benlorenzetti/2015-03-04-Emitter-Coupled-Oscillator/matlab/vary-ce.PNG

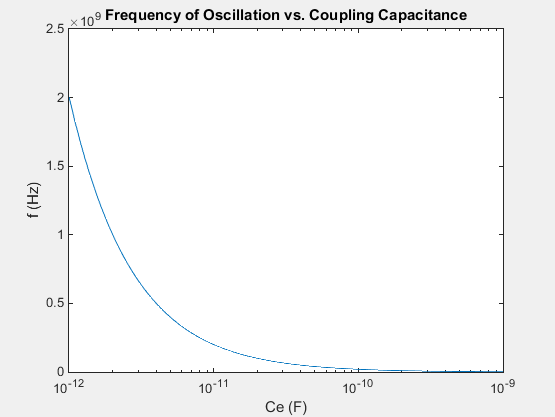
matlab/vary-ce.PNG
