benlorenzetti/2015-03-04-Emitter-Coupled-Oscillator/matlab/vary-icsat.png

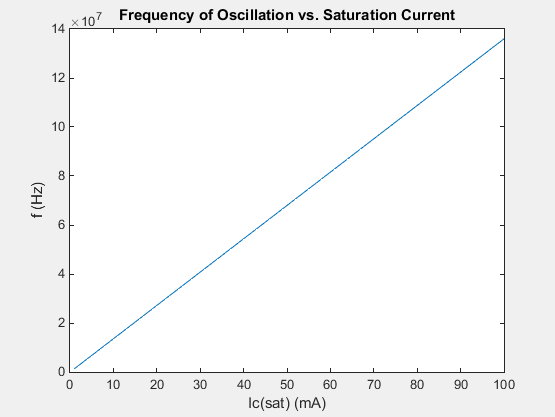
matlab/vary-icsat.png
