benlorenzetti/2015-03-04-Emitter-Coupled-Oscillator/ngspice/advanced-square.png

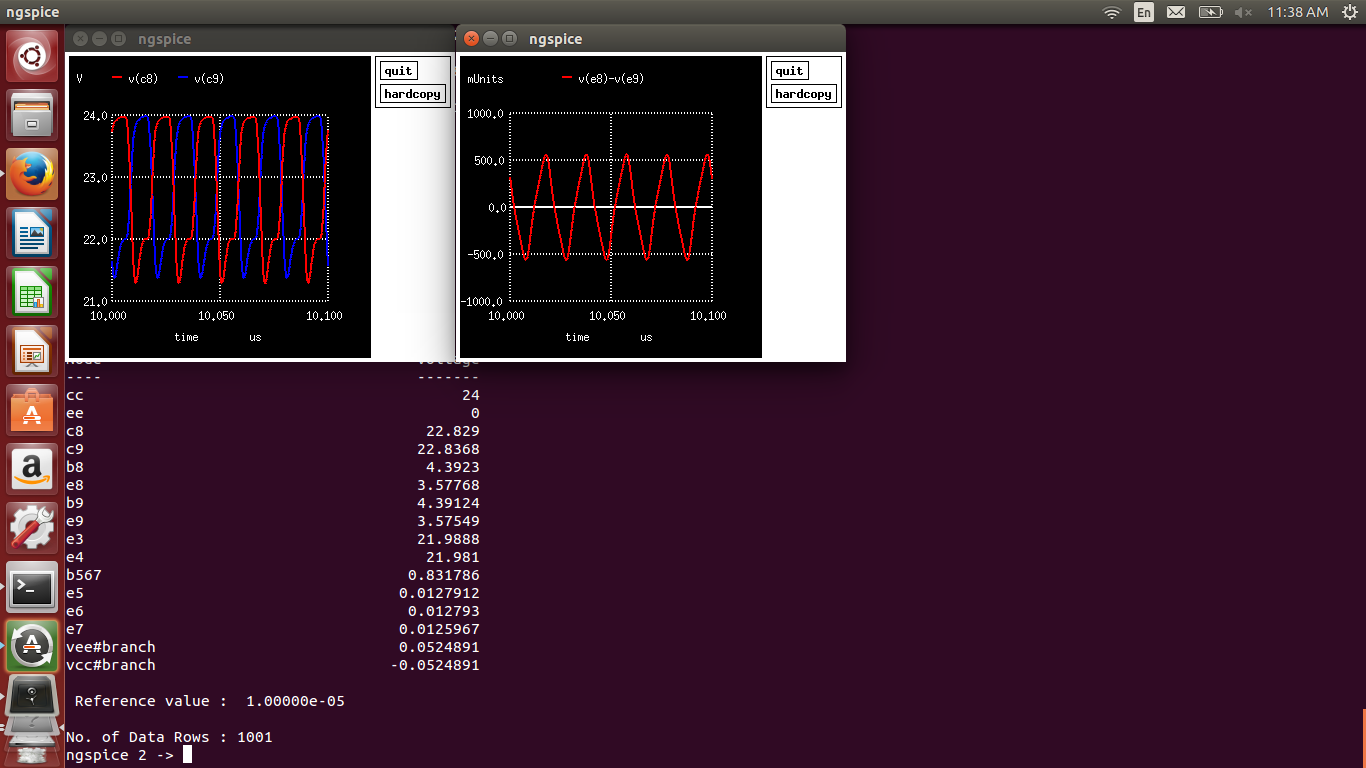
ngspice/advanced-square.png
