benlorenzetti/2015-03-04-Emitter-Coupled-Oscillator/ngspice/simple-square.png

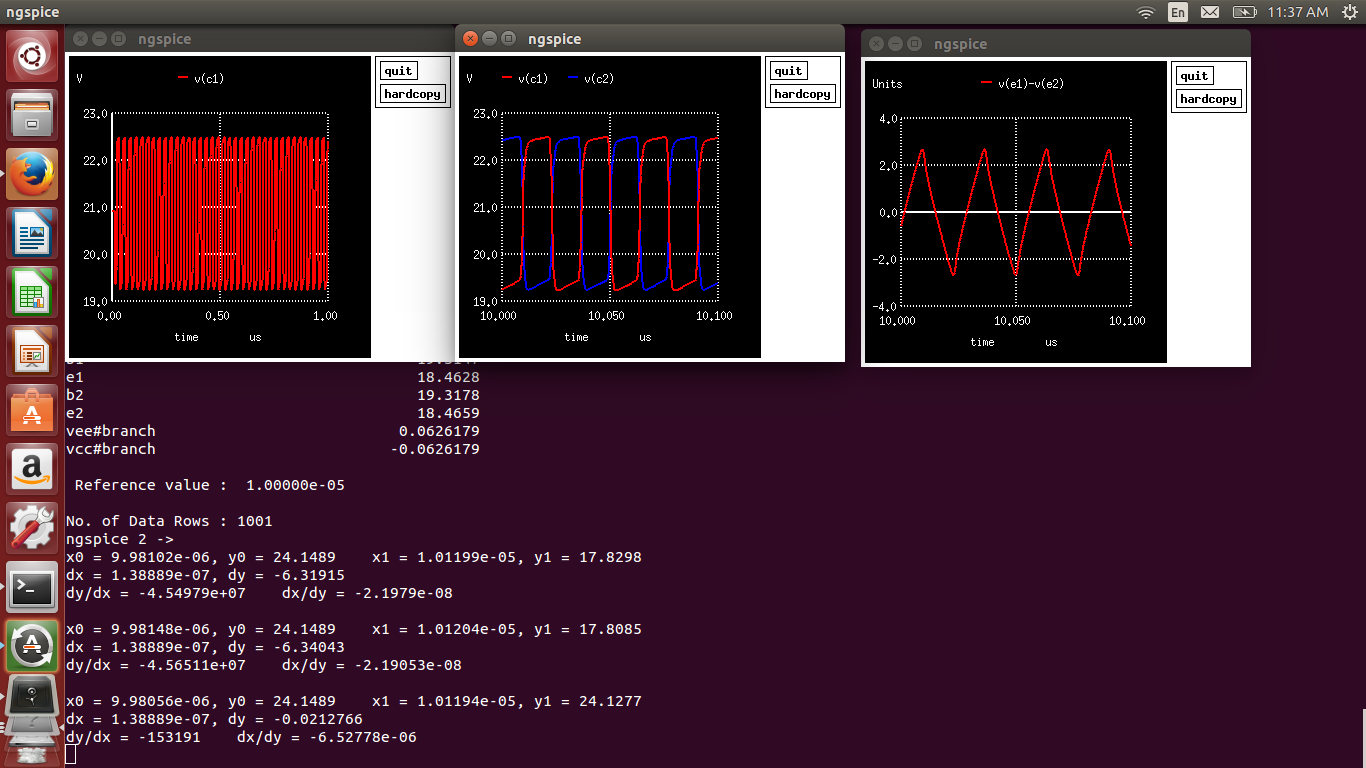
ngspice/simple-square.png
