benlorenzetti/2015-03-04-Emitter-Coupled-Oscillator/results/bjt-characteristics.pdf

TEKTRONIX 571 Curve Tracer

Move cursors IIIIW Pma.x = .1 Hatt Ib.lstep = W uA tl· of stelE = 10 I
F.~loa.d = .25 Ohm
20 l .... : .... : .... : .... : .... : .... : .... : .... : .... : .... :
J | : | :

I

I | : | : | _:-· ~ | , | : | ·. | : | . | .~ . | _.. ... -- ' | . | . | . | . | . | . | . 2 | . ,....- . | . | . | . | . | . | . | . | . mA/di•) 1 .... ;.>··· ... ·~~~~· ........ : .... : ... ·~~--:

Ib= 7£1 uA
I •J ',1 L 1
l
1'~' '=' ,., . .(; l.L.•·-' mn
ill: ~--------- | . | . | .
- • • / . • t" • •••••• .:......:.....: ~ | ..,.....,....,..., •••• ··.-.-• .:...... ••-. -•• -.-. -. ~ ,.~·. | ~ | .- | . lll > ..---· : | : | : | ' | . | . | . | .
If t.... | . | . | ·- I | .•.. | . . | . | .
. · tr>-~·--:· · · · : · · · · : · · · · : · · · · : · · · · : · · · · : · · · · : · · · · : ~ | li/· | . | . | . | . | '--
ilf-.-.~ •....• _ .•....•....•....•....•....•
~b~ 73 uA | J• [)---+ ••••••••••••••••••••• '· ••••••••••• _; I ! | . | . | .
j . (---: -.. -· ...... : |

1
.-1 .- ,., c:.b mH
. ' ..... . ·.---..----...---.-----.----..--· ._. . .
(.: | ,.-
/

0
hFE= 176

Screen copy (since power up) #6

y, -y. -;. W\ ( 1(.._ - )(, )
JZ,3.,.A :. 6.1 ~(2 V +VA)

### VA :.1'2.1 v

Telc

500 mV/di• .. ; | 5000
- v,

Af ~ v

}

TEKTRONIX 571 Curve Tracer 02

Move cursors IIIW Pmax = .1 Ha.tt
o·J.,-d· - .-,c (lh,· I\ dd. - • C..} 'JO '"
Tl; /.::t "t1 = ·11/j IJH" .d.·'·-· ·Cr... | ....L | t
.i.-. ni· dpp~ = 11;1 11 | -I ·..: ···- .. "-~ | tl

•")

c.

20 1 .... : .... : .. '. : | ' |
I : : : . . . .
J . ' ' . : .. ' . : ... ' : .... : .... : .... : .... : | ' ... .
l I | ' . ' .. ' . ' ...... ' ' ' ' ' . ' ....... ' ........ '
rnA. . .id i ,.,. 1 | . _____ ._.:_-___;~-_...J ____ . ·---··-:
I | ·' | .

Ib= 80 uA

## I .-, II

.::: v
_,.:, .. 'J '~'~'·A lL.. •• i... Ill
1 | ' | I | /:-•_,.: .... ----~· It .... ·< | .. | ~ | ·._ | '___.J
l··.tt~~>;-~: | -~····:····:····:···-~:-···:··········
~ . ~i. /~-. . . . : . ' . . : . ' ' . : . . ' . : ' . . . : . . . . : . ' - . : - . | . . ' . - .
., 1,,/ : | ' | . | . | ' | . | . | . | :-··--.
~ ,/"-: Ib= 80 uA | i . '(:...: | ·._ | ;
1./': | ''.' | ' | ... ____, 5 \l

1 ':'1 C: r·A J.i...•·.! ,II

t- FE- 1 r::'J fl - 1-../..J

1. ·-~- | ~--; | ~ .. I .. t .. : | : I | f _,.-.:....._·.· •. ---'---.....__....._~ i ·[_> .. '.:' .. ':. ''.: ' ... : .... :_· :~.·:.' '.:'' .. : .. '.:

1 _.(_ .. :' ... :'.'.:' ' .. : ... ': ... -~~-~~-~-~~

1

,_71, | I / | . | . | . | . | . | . | . | . | . TeJ<: ' i | .
| 0 | | | | | | 500 m'v'/ d i '-.! | | | | 5000

Screen copy (since power up) #1
J2.SM/+ -12.2...,/J,.

## s-v -'Ev

## y-.-;.) -: Wl()(.,_ -K, )

!2.2MA -=- 0./.~ (z V .- V,. )

# vir -:. 12a ·v

TEKTRONIX 571 Curve Tracer

Move cursors IIIW Froax = .1 Ha.tt Ib/step = 5 uA | hlr ·nt·· .::·+ t'- n·~· = 1P l1o L | ·-· ·.- f""-" | 0
Rloa.d = • 25 Ohm
20 l" ... : .... : .... : .... : .... : .... : .... : .... : .... : .... :
i- ... : .... :- ... : .... : .... : . . : . . . : . . . : .... :
I | . | . | . | . | .
2 | j | mA/ d i'J

1

1 | ._. _ ______. --· _......____..,....,.--· | ~-r
I | . ---- | . | . | . | . 1 . . . . y'· . . : . . . . : . . . . : . . . . : . . . . : . . . . : | : ·_;
I | /· ~--· | .----. | . | . | . | . I | .. -~ | . | . | . | .
Ib= 40 uA | 1 · · ~:<::~~ · · : · · · · : · · · · ~ · · · · ~ · · | . · · · · '
I '") '.i | l | (! .. . | . | . | . | . | . | . | . | . | . c. y | i p / . | . ,___,____., | ' | ·.-- | | | .
11.8 mA | ~-~;~::;./~- · ·_: · · · ·: · · · :_i_· · · ·: · · · _ :-· | : · · · ; ·--~-~
j | If'.--- | . | . | . | . | . | . | . | . 1 ·rl · · · · · · · · · · · · · · · · · · · · · · · · · · · · · · · · · · · · · · · · · · · · · · · Ib= 40 uA | 1 | i ....--:- | · | : | : · --: | : | :· | . | . ~
5 \l | J ~/_..- : | : | : | : | : | : | : | : | : | : 12. 1 mA | li--·..:--~-~ . . . . : . . . .;_,~ : . . . . : . . . . : . . . . --: . · | : ,_._.~·-·.-:
i . -/~-~- .... : .... : ... ·0·~:--~~- .. : .... : . . : .... : ~~ I | . | ._. __ ._.._.~.-.. j
' | {-~·: . . . . : . . . . : . . . . : . . . . : . . . . : .. · ~~-_:__~~~~~-~-~._:_,-_:
0 / | Telc

0

Screen copy (since power up) #2
1'2./wtA - Jt:,t>~A
r-v -'2.."

500 mVldiv

### y\. -y, -: M( )(-a. -X, )

1/.t/ M If -:r 0, I ";;A ( 2 V 1+ ~ ) VA -=- 116 v

### s0aJ

TEKTRONIX 571 Curve Tracer

Move cursors llj- Pmax = .1 l~-latt Ib/step = 10 uA Rload = • 2'5 Ohm
20 l' ... : .... : .... : .... : .... : .... : .... : .... : .... : .... : j····:····:···: .... · . : .... : .... : __ ·-: ~

# ff~,/dit.) ]'.'. .~-''

__ ,.: . ...:-----~~' ___ ..,...., | ':
'' .: ':' '=--·.:'. . '':''' . | ':' . | . ''':' -~ . I . | ? | . | . | . | . | , | , | , | , | , I f7> | - | ... Ib= 70 uA

12 v
12 rnA
11: .. jiJj-,-<"_:,_~·-~ ~ | ~-'' ': ''' ': .. '.' '.' .. I! _.- | . | . | .
~ . ~/~-~~ .. : .... : .... > ... : .... :· .... : . :--:
I | I/ ' | . | ' | . | ' | . | . | . | ' | .
I { _:.. | : | : ·-. | . | . | . | . . | . | : 1 . ! _:.-""''; ...... ' | ' | ' ... .
Ib = 70 uA | I ( . | : | . | : | : | : | : | ; | · | · I i -~- | -··. | . | ·. | . | . | . | . | . 5 v

1
.-! 'J r·iH···, c. •. J d

hFE= 171

i ' /'· . : ... ' : .... : . : .. : ' ' ' . : . ' . ' : ' ' ' ' : . : . ·.: .. ' . : ' ' . ' :

I (-- . | . | . | . | . | . | . | .
~ . r .. : .... : .... : .... : .... : .... : .... : .... : .... : .... :
I . -· | . | ~-·~____, I '/ : | .
J ... : | ' .. I | • | . | ._._._.--..-..-.-.:--:--:-.:......:.....:.:.....;_;_..;_;, I ..--· . | . | . I ;/ | : | Telc
0 | 500 mV/div | 5000

Screen copy (since power up) #7
f'J.,3t'YIA -12.a """'A

### s-V- 2.V

## y,. -y, -: m( )(, -K,)

## !2 ""fr " 0.1 ~ (zv .. v,.)

v~ -::.. ;;,; v

d
= <:J. I V

TEKTRONIX 571 Curve Tracer

Move cursors II- Pmax = .1 l·la.tt Ib/step = 10 uA | t,l.-, ,-..j: dpr,-:; = ·1q I 'ff. ._, 1 | •-• '.''- t-'v | J..t_,
' P.'ll-ld-d. = ~·c:: nt-, ~n , , | -- | I S....'.o' | ._.flli 201"": .... : .... : .... : .... : ... ·: ... : | I | . | . | . | . 1 |
I | : | : | : | : | : | : __ :_~ | . | .
m~div j .... /r~---•······;········· ;······· I | / -~· | . | . | . | . | . | .

Ib= 7£1 uA
1

.-, 'I
c. v
12 mA

Ib= 70 uA
5 v
~ .. -, Ji
C:..J filM

hFE= 171

1• {{----~ . . . - •....•••.••• '' • . . , .... i
J.I(C.• ·' /r .

.... · .... ··- ...•....•....•.....•....•. ~
. <--~-~ | : | ( | : | ...J-·.--~--
~ ,·::,·.: ,·r··········~··················~····.····· " | .... : .... : ·.· .. : .... : .... : | ·~~~~~
I If | · | · | · | · | · | · | · | · | · 0 1 )>~:. : .... : .... : .... : .... · ... ·. · . ~-· -~~~~.;....:.· ·....:_· :.....:..· · ..:...:· _;_Tel<.:.....:.· :
0 | 500 m\i/d i <,! | 5f:J00

Screen copy (since power up) #3
12 .. 3MA .. 12-NtA | 1 /
m-=- sv _ 2. v | -= 6 .. ,,.,1/;v

## y\ -y, -:.. M ( K'-., -y, )

### /2m/+ ~ o., ~ (z..v -rV;.)

v" ~ 1;; v-

TEKTRONIX 571 Curve Tracer
06

Move cursors 1- Pmax = • 1 !,Jatt Ib/step = 10 uA Nr of steps = 10
Dl ... -~ - ·:n:: r"ll·n· 1\ Ud.l1 - , ._._.. ·" I I
20 l .... : .... : .... : .... : .... : .... : .... : .... : .... : .... : I | • | , | , | ' | • | ' | • | • | ' | '
j .... : .... : .... : .... : .... : .... : .... : .... : .... : .... :
I | . | . | . | . | . | . | . | . | . | .

## I . __._ -. -·

-; .... :_·_ .• :-·-"·:····:··································· .~. ,• I' I

•"I

c:. | .---~--~~--------
ffiH/QjiJ I | ..' | ' | .-..-'--~_,__,.---·~.., | J | / ----~ | .
j
... (~~c~~~;_~-- .. : .... : | It .-·· | . | . | . | ' Ib= 70 uA | · ·v·.~.: · · · · · · · · · · · · · · · • · · | · · · · · · · ·~··. · · · · ·
1 | l.,v:=• .... · < | -:-.-.-.:
.-, 'I c. \1
11 q ~H· ,L,L,, ii! | 1 .-~ . . l | . . l | . | . I | i | . | . | . | -~
Ib= 70 uA | i -~i~,.:-/:~·· ..... : .... : .... : .... : . · ... > .... : .... : .. ·~~

J . !i(~-: .... : ' ... : .... : .... : .... : .... : .... : .... : .... :
12.2 mA | I J _.:._____,_. • | . | • | ,_;...... | . | . | . | . | • | .
~ . r- : .
j ·~ ••••••••••••••••........••••••••.......•. ·-;J

,.,
~I
hFE= 170

Screen copy (since power up) #4

t:;iil0, n· 1J / .j 1· u '"'t:J | I, t ll .,
| I 2. 'Z 111 A ... IJ. ~ A-1A | ~~A A-
M::: | 6V- 2 V | .:. 0.1 V

y._ -yJ : M ()(),., -Y, )
JJ,fft1/t = o.J ~(zv ~vA)

## ~VA-=- 1 tr v

t:;fAfA~l ._.tJtJ_

TEKTRONIX 571 Curve Tracer

M...ve cursors •• ..- P'm.:.'· - ·

1 11n-++ | Th.l·~tPp = ¹0- ,,o I"PJ | 11•1- | '•.J.J:. | - ,l i'l-·'·· ~ | ~ .... ~· ~- •. | l | _,,, | Nr of steps = W
hi] ·

1 .-,c: "h , .. oa.o = • c.... u m
20 1'"': .... : .... : .... : .... : ... : .... : .... : .... : .... :
J .... : .... : | I l | ·.---- :J | I | : | : ~__;_.---7-·----·· | . | . | : | : | : l- | 1'''''''~ .. -.---: | "iH'"··ldJ.t! I | : /.-·"" : | : | . | . | . | : | : | . | . u:, . | ·~ | .;r
l | ----- | . | . | . | . | . | . | . | . i .. />--~.--~-. : .... : .... : .... : .... : ... : : .... : .... : -c.~

I .i ./. _.r-~
i/ ~---- | : | . | . | . | . | . | . | : __j Ib= 7[1 UH | 1' F· /'· ' ' ' ·._..:....:...;_; . . . . | ., ' ' ' ' ' ' -~ . ' . ' if/ .:...------ : | : | : | : | : | : | : 12 v | llf./': | : | : | : . . | . | ' ~~· -.........--·
11.'3 mA | i · !/>-:__ | : · · · ·: · · · ·: .-. · ·: · · · ·: · · · ·: · · · ·: · · · ·
i / -_,___:.. | : - : | : | . | . . ..-. --.--··-:
~b~ 70 uR | j (-· _· ·_· ;~ · · · ·: · · · · · ·: · ·. · · · · i · · · · .-~~ · ·: · · · ·. · · · ·;
i ., (· . ' ' . ' .. ' ' . ' ' . ' | ' .. ' . ' ...... ' .. .
12.2 mA | il· ( ....•. · .•....•....•.. ~_:.· ..•....•....•....•
I / . | . | . | . | . | . | . | . | . | .
i { .. _: .. '':''. ':.'.': .... : .... :' ... : .. '.: .... : .. ~
0 I )/- : | : | : : | Tek: I '
0 | 500 m'v'/d i l.,.J | 5000
hFE= 170

Screen copy (since power up) #5

## /2, 2~4 - IJ.?,y;A

s-V- 2..V

## )4 -y, -=. M()(,_ -)(, )

### II\ i wz A -=- 0\1 ~ ( 211-f tl~)

## v/'r -=- 11 1' v

TEKTRONIX 571 curve Tracer

Move cursors •• Pma.x = .1 ~\Jatt Ib/step = 10 uA | 'ir n+ :::t.ForJ:=:: = 1P I | • 1 | - • - i - | t.!
~~load = .25 Ohm
'Jiit ~ | | '-t! I | . | . | . | . | . | . | . | . | . | . I | : | . | : | : | : | : | . | . | . | .

4,····:····:····:····:··.·_·:·~---····-: "~-:"-~
•"'\ | . | ~~ | ...... | . c:. | . | .-- . | . | . | . | . | . | . | . | .
- mfl/d i'v' 1 .... >/_ .. -. ~~_:_,_·_· ~--: ·_· ~· ....... -~ .. · ... : .... : . ~-.
I /. ~_..,... .

Ib= 70 uA

r' . ,.a•" | • ...:------"-'· __ __..~,.
.. /:.:./c.>--~. : | --- | ,...,.....,.· | : .... :
I' .. · | .-....J......-------~-~-·-....,..· ___..,__J . 1(/;.-~_.~~-.... : .... : .... : | l~~ .... / : --·--¥ | : | : | ~ . | . | . | ----r
. /' ;.-""-7' | ; .-· . / ;._.~--...------....--··-~.,.--_:...--:---'----' j | .-·· • | •
. / | ' | ' . ' ... ' ... ' .. ) | . } | . --'-----'· .--~----------' ,..._,...---.--.......
. l/~--~: .... : .... : .... : |

1

.-, !I I"' II

L ?
·i .-, •"'\ (i
!C:..C:. ff!n
Ib= 70 UH
5 v | I 1_.--·-: -- _ ___;. _ _.;.__......:. .-..,_..,.. _ ___,_ _ __._ i . (:...:..: .... : . ~ . .:.;.._: .... : .... : .... : .... : ... -~:~: .. : .... :
I [.., . | . | . | . | . | . | . | . | . | . J . tl··~.:.··········································
0 /.-- . | | | | | | | | | Telc
0 | | | | | 50t3 mVldiv | | | | 5000
hFE = 175

Screen copy (since power up) #1
.LJ.t. mA-- 12,2 m4- D .. I 313 MTJ ~V-2V | - | V

## Y~--y~-;: W\(x1.-x;)

## /2.2.t~4- ..., o. /333 ~ ( 2 +t4)

# V,+ ':- RiS v

TEKTRONIX 571 Curve Tracer

Move cursors - | Pmax = .1 l-~att Ib/step = 10 uR | t·J,... ,.., t·· ~t "'P~ = v:~ ll1 iJ .::, .·C' » | .d:J
| Rl ⁻~-d - ·:;·:::: i'h· Ld - , (..._! ~·all

2

20 l | :-;...:....:..:-·-: _. :_,,:-· ';.....;.'....:..' --

1

, | ___ .--..
-~~----
i
l .... : .... --·: ..... : .... : .... : .... :... | ---.........-r--: .. | ·-.:.~---·.--,.
I
I | .: .... ·/~~---';--~
mR/div 1 .... /: )'/ . . : | -·-· -· . -~·.._---""·_,....,....~-:-. ~. -:--: ..~. -~-.-. -. -.. } | ,.... | ,__.....,....--, | . | . | .
j l /· __.---: | . | . | . | . | .

Ib= 60 uA
12 v

·j·J ·1 ,.,..() lL.l llln

Ib= 60 uA
5 v
1

.-, 4 ~ c: .. mH

hFE= 201

I . .l.l.>··< . , : . , , , : : : :·--.. -. -. : ...... , | I | (If·-~ | . I lf..i ./- | . | . I i ..< | . | .

1

. •'f ... ·~ | ''' •. ,...,.: | / ·...?·-- | . I | ,..-.-
J | / .... :
1' ·-~---~
I / . f : | . | . | . | . | . ., _ _.__ _ _.__ __ 1 . f~>: | : . . . . : . . . . -:· . . . . : . . . . : ~-- . . : . . . . : . . . . : . . . . :
J I | , | , | , | , | , | ' | . | . | ,
. I . .--:--:--. . . : | , | ~·:-:· |

# J . L • | ~·- | -. - | -. -.. ---- .. I .r :

4
Telc
0 | 500 mV/div | 5000

Screen copy (since power up) #2
m=
12. Y""'lf- - 12./,.,.A
5V- 2V

# y ... ~ y, "' M (x-A-)('' ) a./~ ~ :::: o. 1 ~ (z v 't' ~ )

## V~r -= I 19 V

~o. 1 MilA;
