benlorenzetti/2015-03-04-Emitter-Coupled-Oscillator/results/advanced-circuit-1k-1k-20pF.png

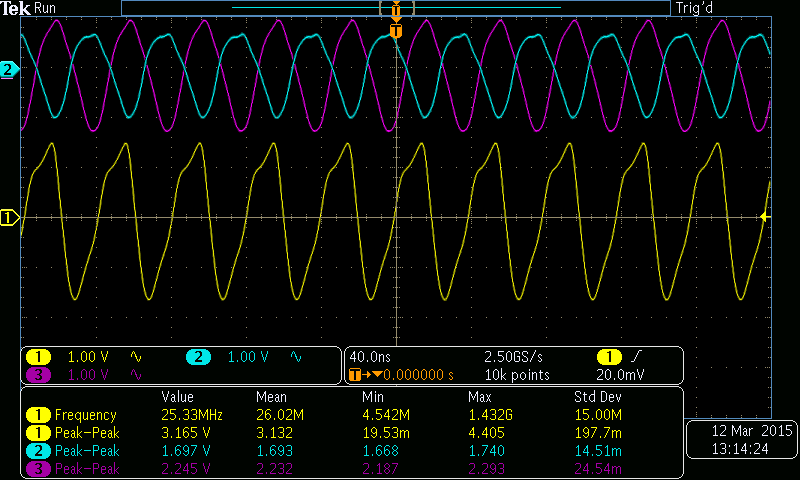
results/advanced-circuit-1k-1k-20pF.png
