benlorenzetti/2015-03-04-Emitter-Coupled-Oscillator/results/advanced-circuit-1k-250-150pF.png

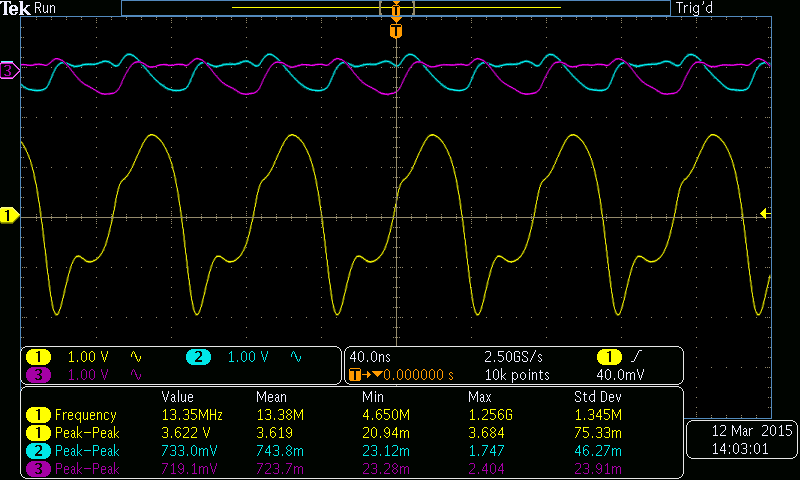
results/advanced-circuit-1k-250-150pF.png
