benlorenzetti/2015-03-04-Emitter-Coupled-Oscillator/results/advanced-circuit-R1-1k-R2-250-200pF.png

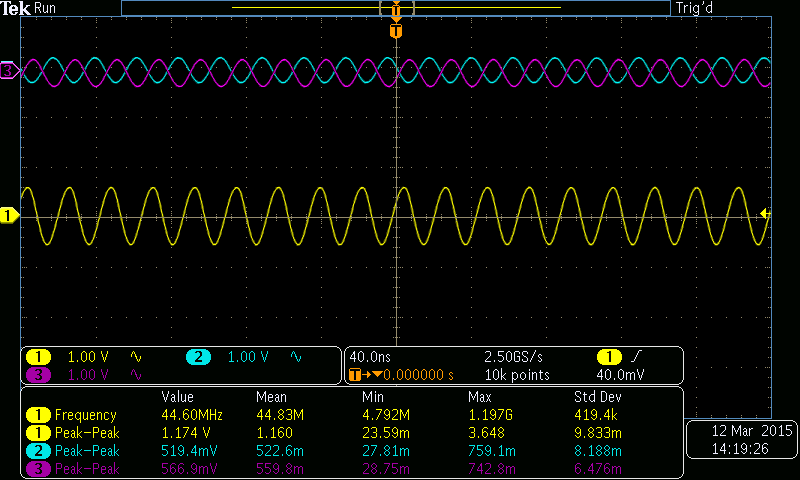
results/advanced-circuit-R1-1k-R2-250-200pF.png
