benlorenzetti/2015-03-04-Emitter-Coupled-Oscillator/results/simple-original-10MHz.png

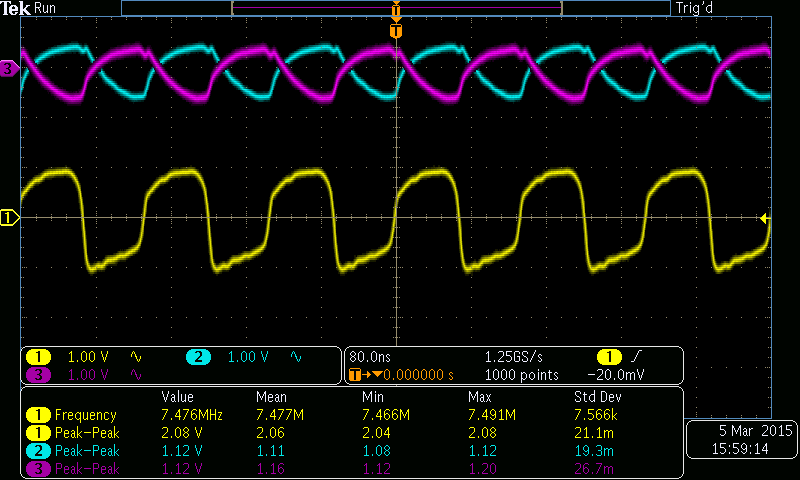
results/simple-original-10MHz.png
