benlorenzetti/2015-03-04-Emitter-Coupled-Oscillator/results/simple-original-100kHz.png

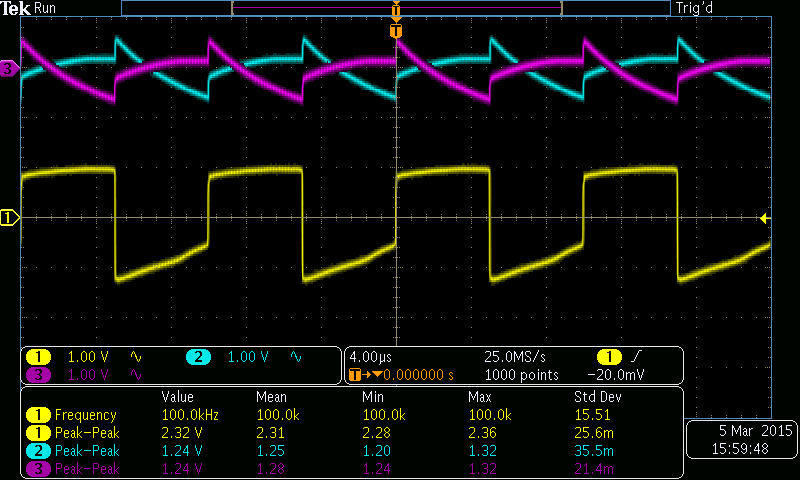
results/simple-original-100kHz.png
