benlorenzetti/2015-03-04-Emitter-Coupled-Oscillator/results/simple-original.jpeg

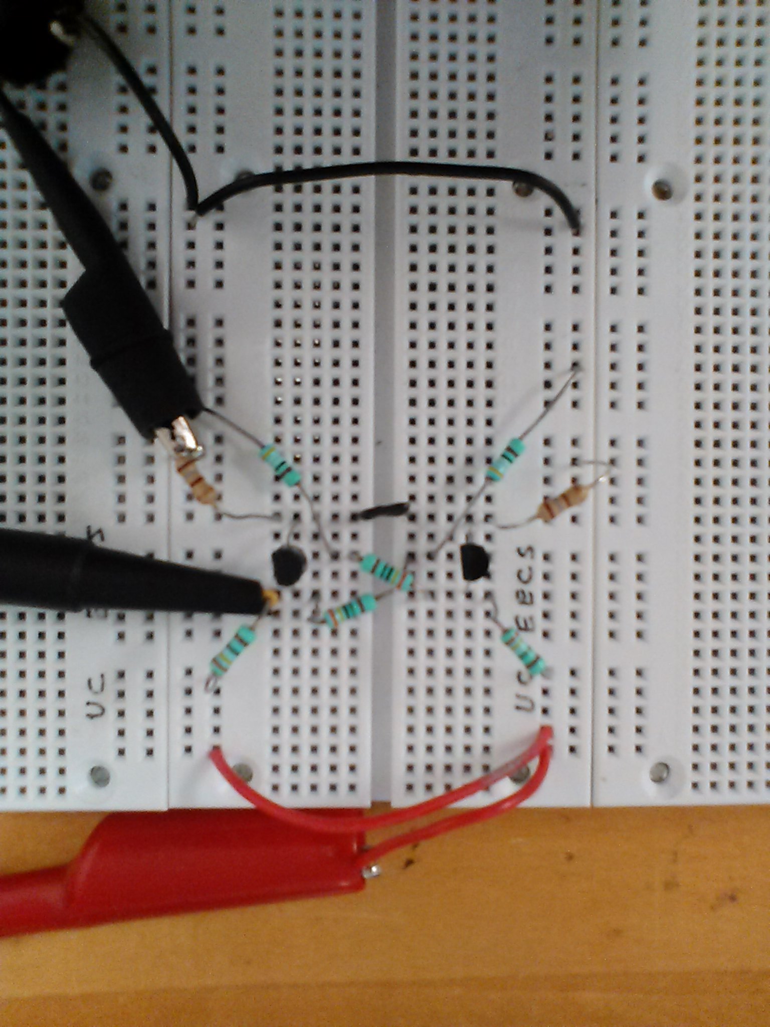
results/simple-original.jpeg
