benlorenzetti/2015-03-04-Emitter-Coupled-Oscillator/ngspice/advanced-circuit-output-43pF-eps-converted-to.pdf

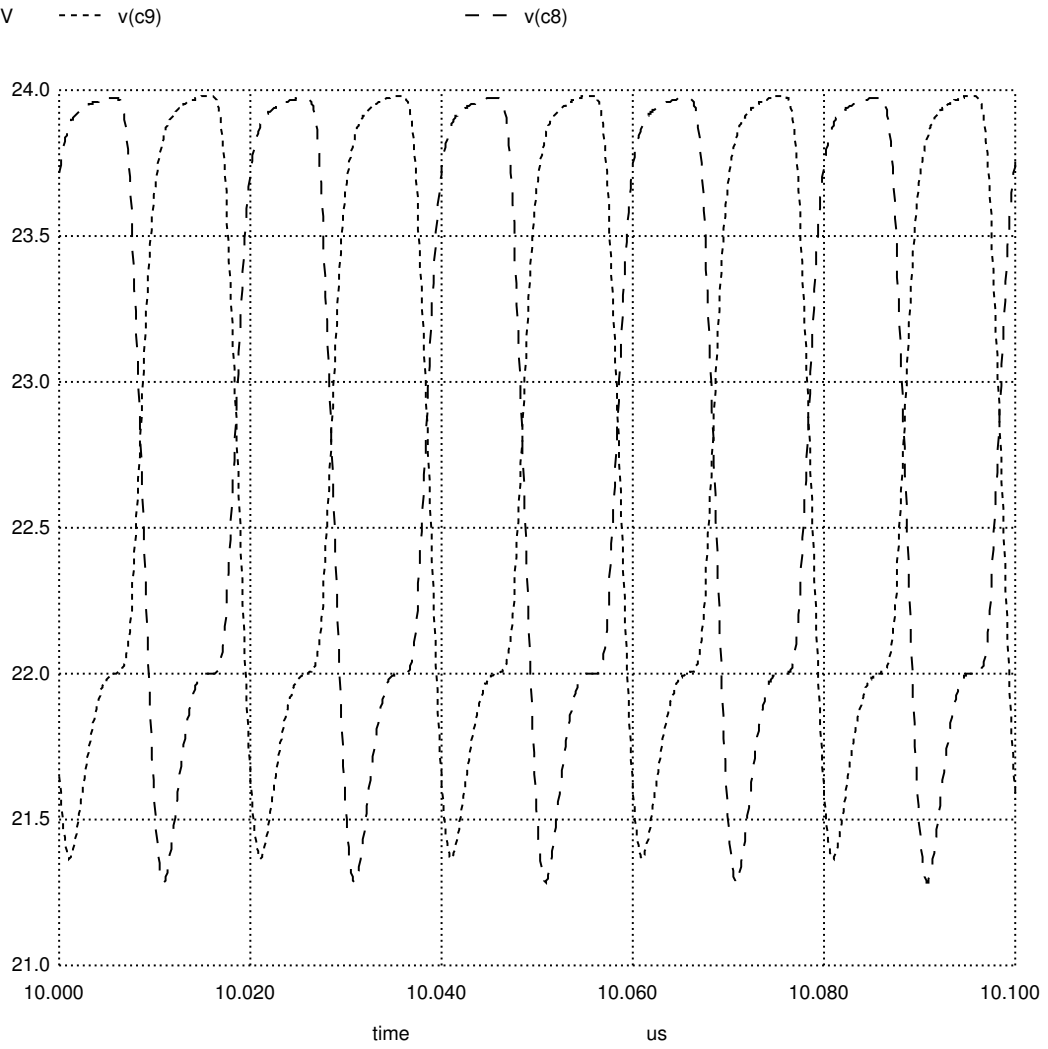
[picture p56: page 1]
time
