benlorenzetti/2015-03-04-Emitter-Coupled-Oscillator/ngspice/advanced-circuit-vcap-43pF-eps-converted-to.pdf

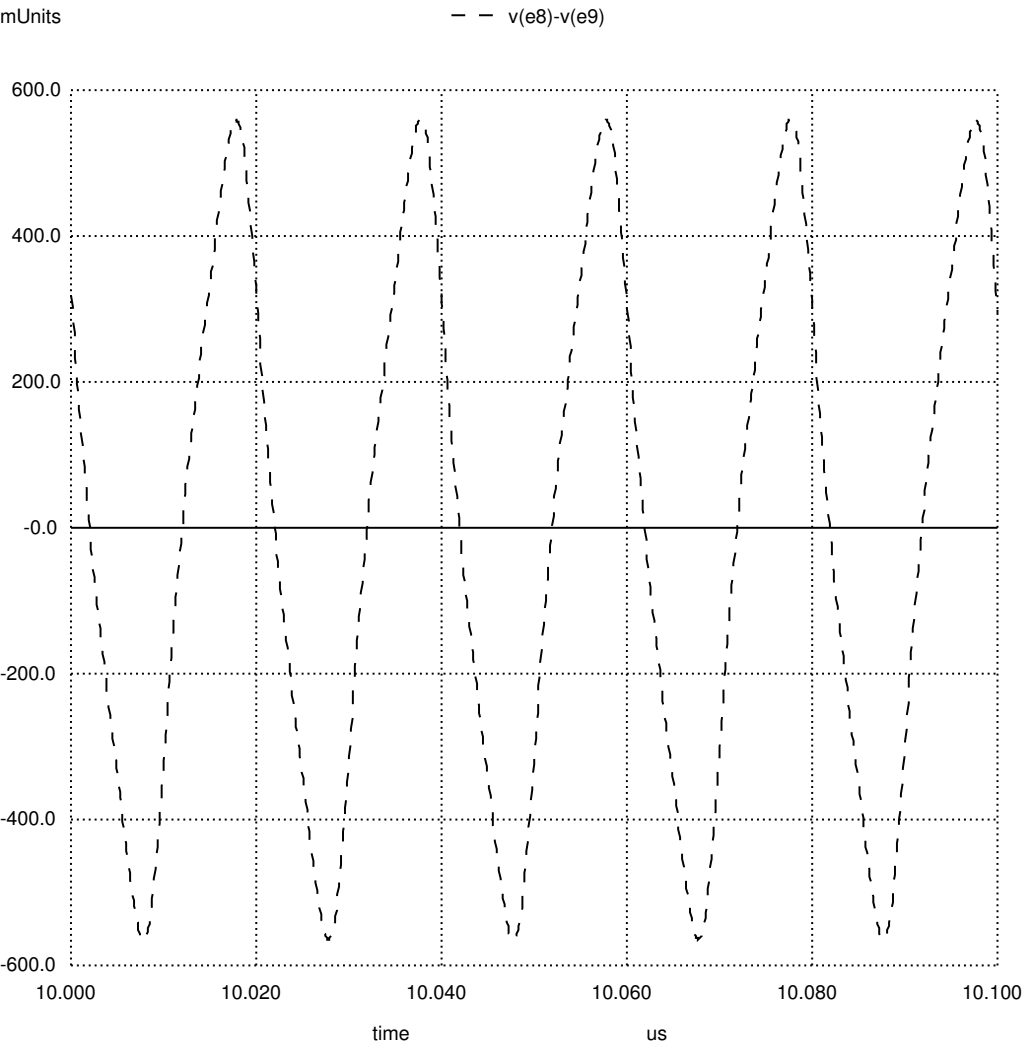
[picture p57: page 1]
time; mUnits
