benlorenzetti/2015-03-04-Emitter-Coupled-Oscillator/ngspice/simple-circuit-output-50pF-eps-converted-to.pdf

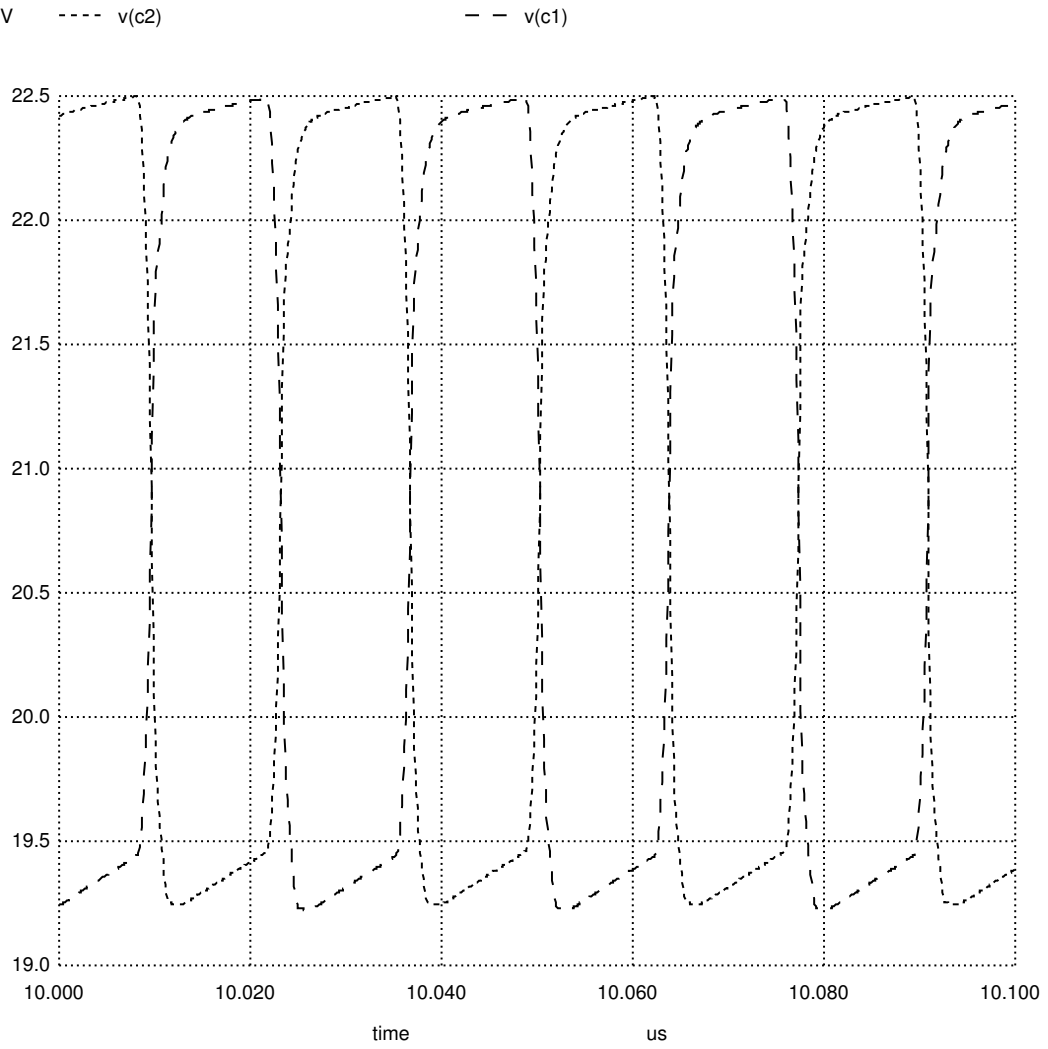
[picture p58: page 1]
time
