benlorenzetti/2015-03-04-Emitter-Coupled-Oscillator/ngspice/simple-circuit-vcap-50pF-eps-converted-to.pdf

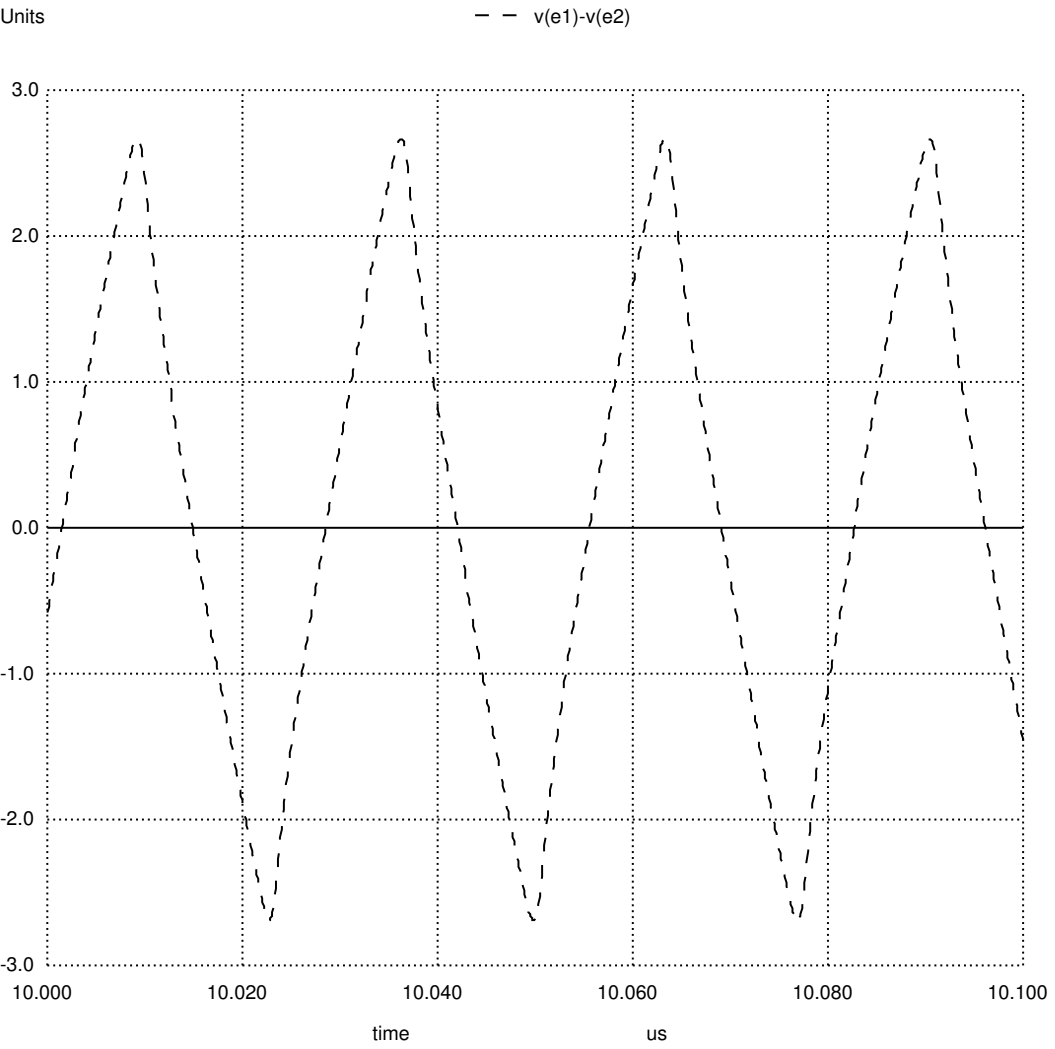
[picture p59: page 1]
time; Units
