benlorenzetti/2015-03-04-Emitter-Coupled-Oscillator/(commit log)

2015-03-05 Simple Circuit SPICE
2015-03-05 Simple Circuit Results and BJT Characterization
2015-03-12 advanced circuit results
2015-03-20 added simple circuit matlab
2015-03-23 simple circuit redesign
2015-03-23 advanced circuit design table
2015-03-26 equations for power point
